VentoTran/HUST_Project_2_20211/REFERENCE/Firm_Lib/2.4inch_SPI_Module_ILI9341_MSP2402_V1.1/1-Demo/Demo_Arduino/picture/Example_03_colligate_test/Example_03-011.jpg

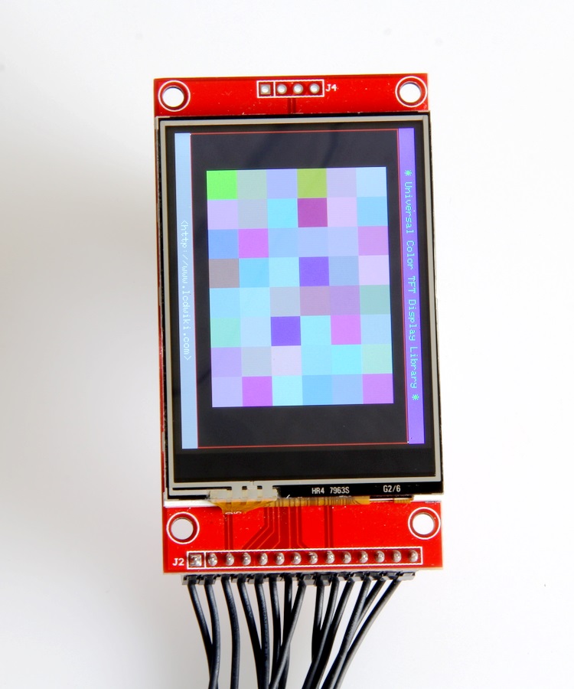
REFERENCE/Firm_Lib/2.4inch_SPI_Module_ILI9341_MSP2402_V1.1/1-Demo/Demo_Arduino/picture/Example_03_colligate_test/Example_03-011.jpg
