VentoTran/HUST_Project_2_20211/README.md

# Project2-20211
Project 2 is a project mainly focus on power electronic devices.
