VentoTran/HUST_Project_2_20211/Images/248281724_363296638787562_6036973718591148069_n.jpg

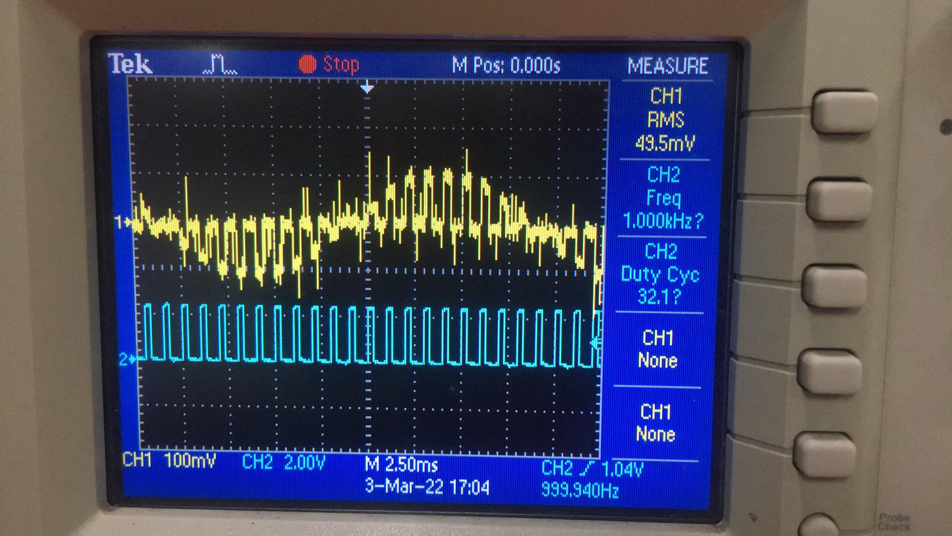
Images/248281724_363296638787562_6036973718591148069_n.jpg
