VentoTran/HUST_Project_2_20211/Images/273696500_965443047669304_2529746146208866558_n.jpg

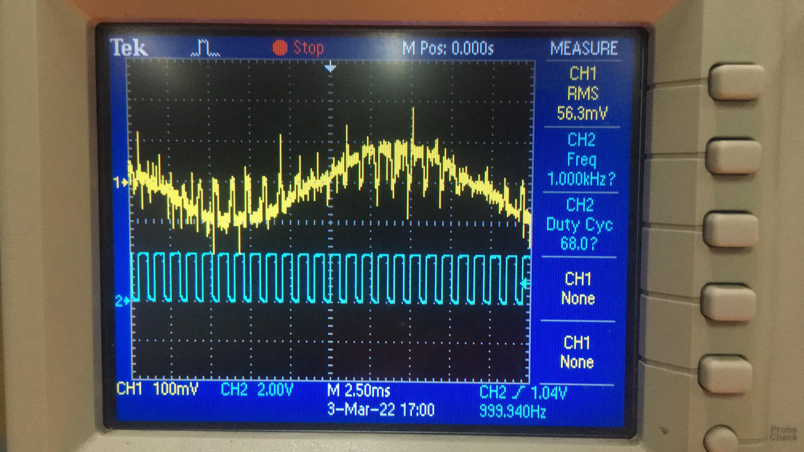
Images/273696500_965443047669304_2529746146208866558_n.jpg
