VentoTran/HUST_Project_2_20211/Images/273705237_665765731232288_4096942778341260248_n.jpg

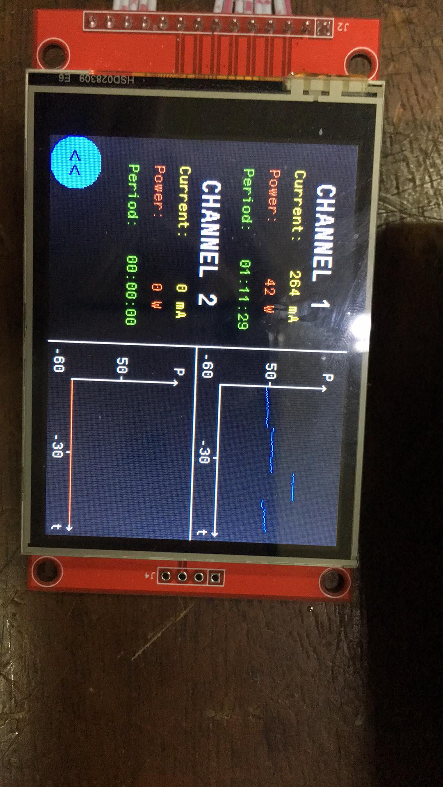
Images/273705237_665765731232288_4096942778341260248_n.jpg
