VentoTran/HUST_Project_2_20211/Images/273864193_5540946679260011_4685652792242781632_n.jpg

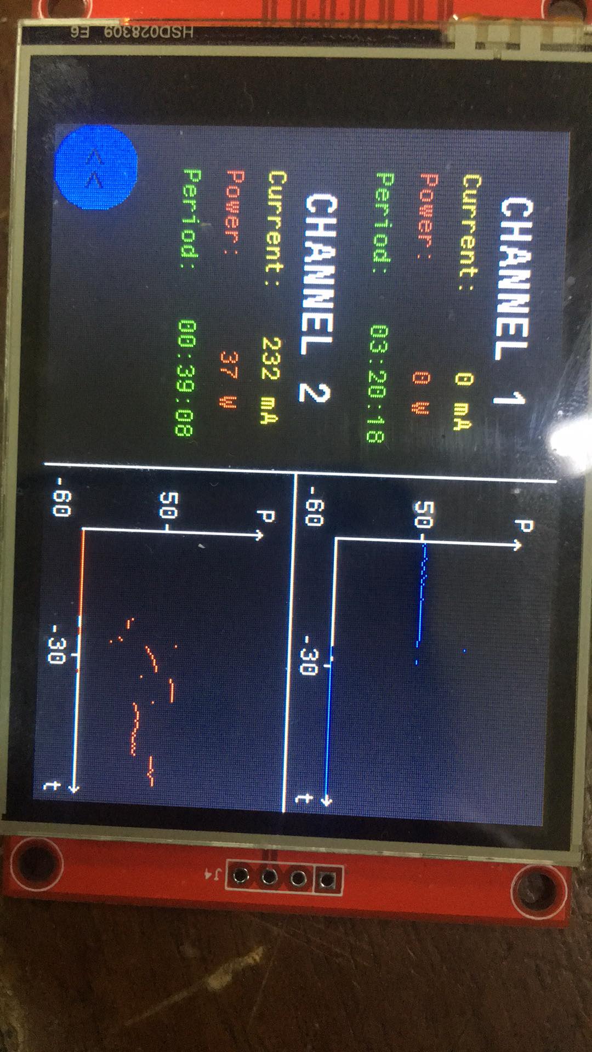
Images/273864193_5540946679260011_4685652792242781632_n.jpg
