VentoTran/HUST_Project_2_20211/Images/Project 2_20212.png

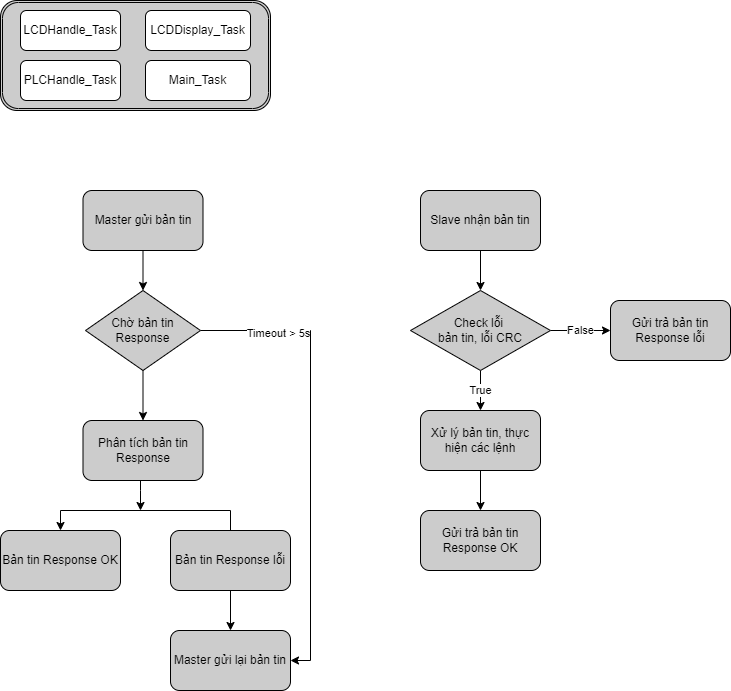
Images/Project 2_20212.png
