VentoTran/HUST_Project_2_20211/Images/Project_2_Slave.drawio.png

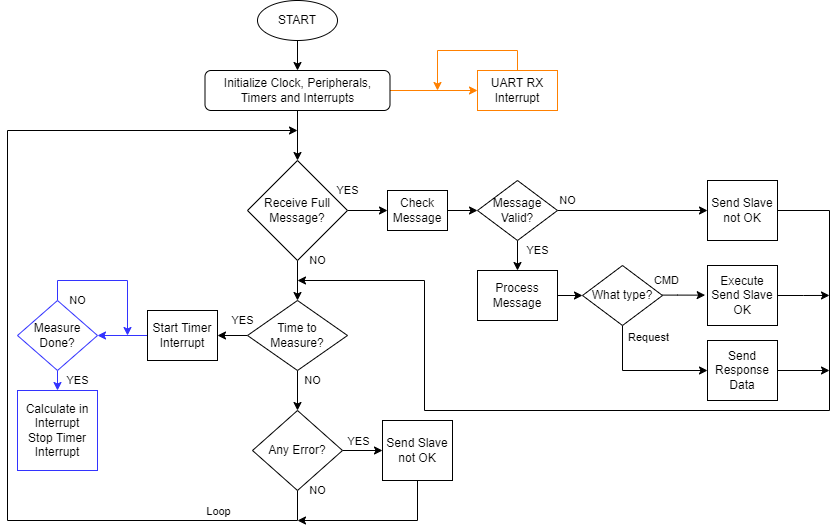
Images/Project_2_Slave.drawio.png
