VentoTran/HUST_Project_2_20211/Images/z3213941388070_df7a3ac738dd3a2199d7acfdcec778d1.jpg

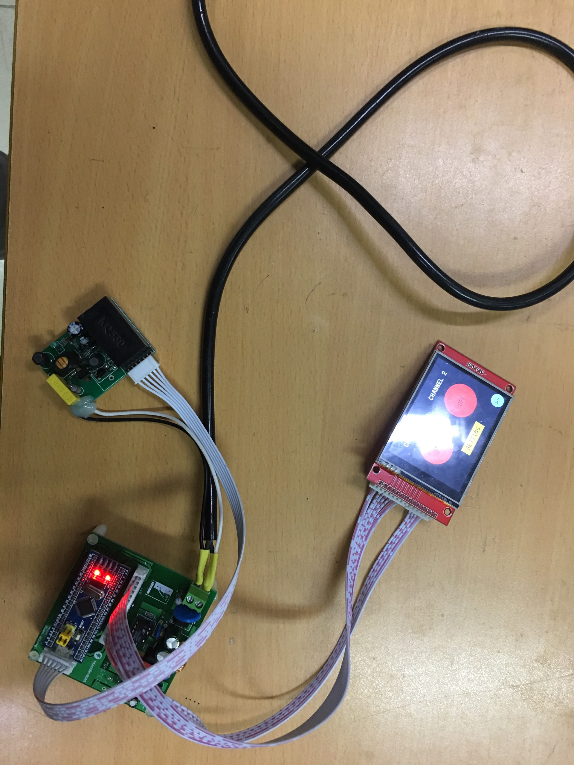
Images/z3213941388070_df7a3ac738dd3a2199d7acfdcec778d1.jpg
