VentoTran/HUST_Project_2_20211/Images/z3213941421099_bf4173346947715221769806f4465ea7.jpg

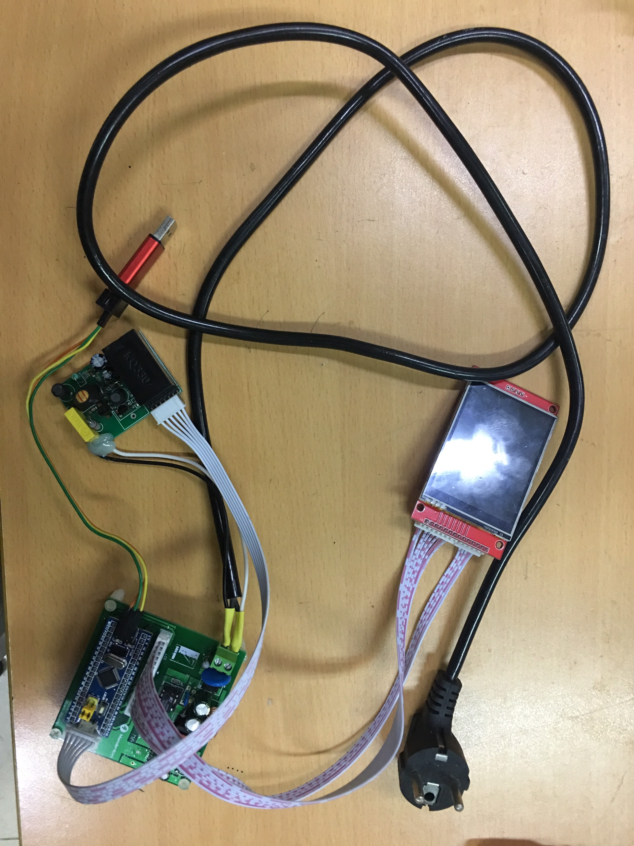
Images/z3213941421099_bf4173346947715221769806f4465ea7.jpg
