VentoTran/HUST_Project_2_20211/Images/z3213941459730_834b902f62a23d79abc02fcaa71281bd.jpg

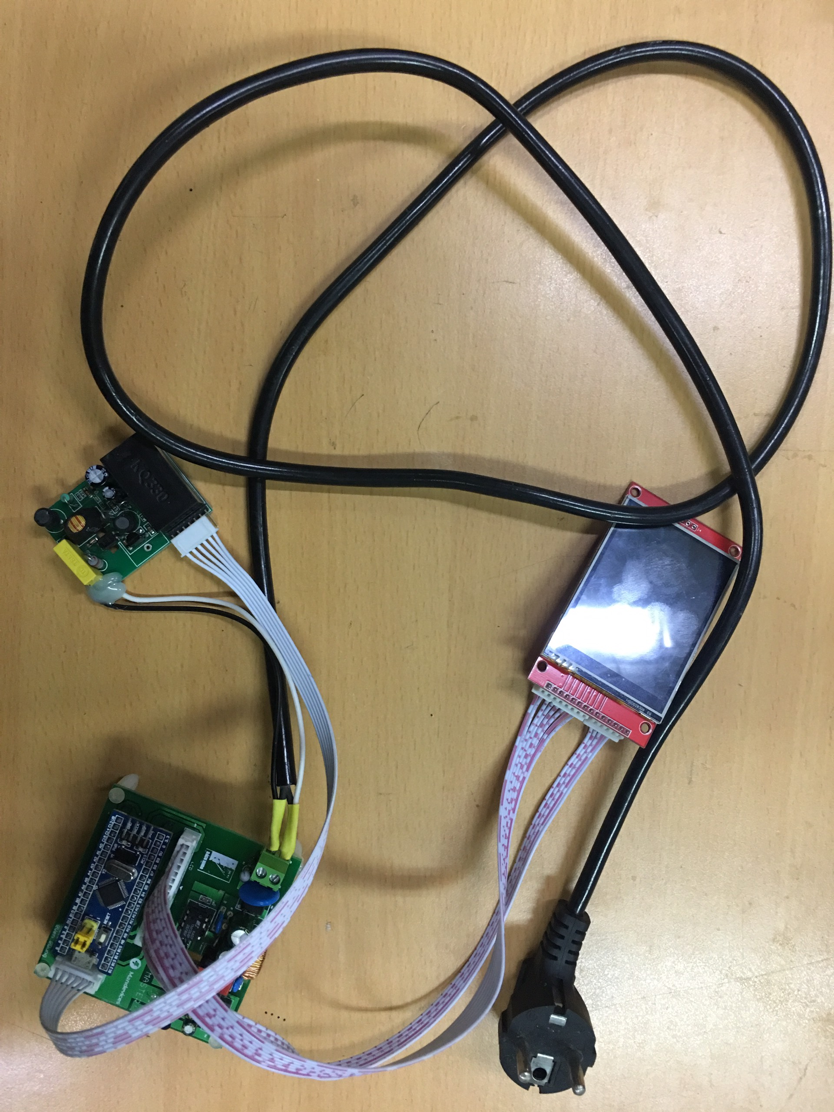
Images/z3213941459730_834b902f62a23d79abc02fcaa71281bd.jpg
