VentoTran/HUST_Project_2_20211/Images/z3213941505135_e4d84758d8ef27eb2e7979a3d5ddf65f.jpg

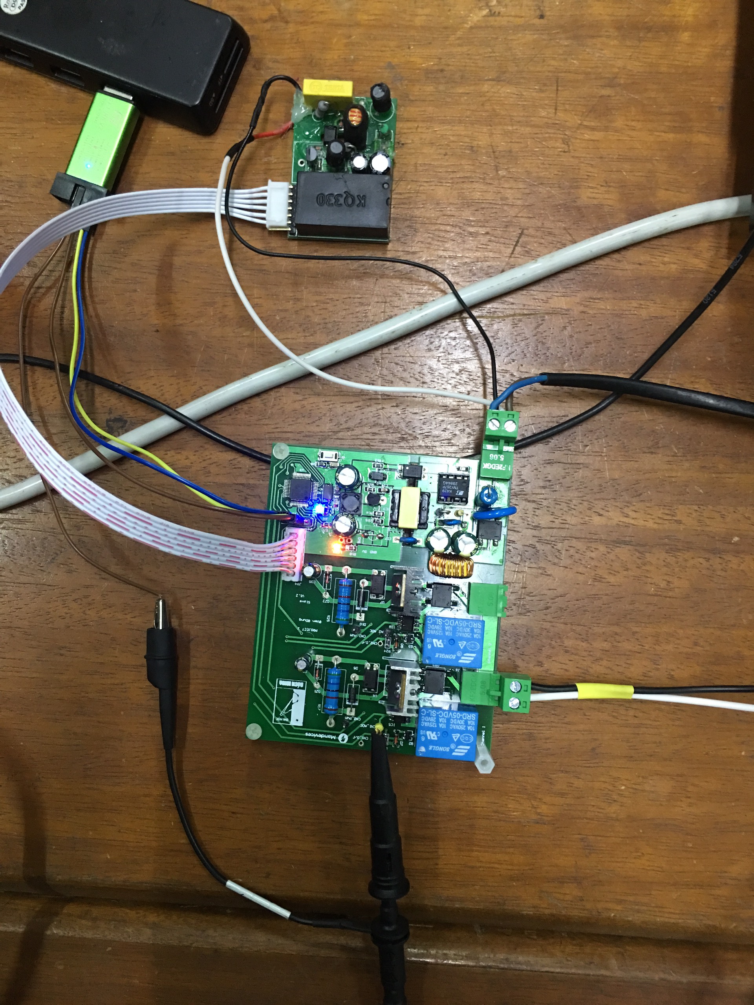
Images/z3213941505135_e4d84758d8ef27eb2e7979a3d5ddf65f.jpg
