VentoTran/HUST_Project_2_20211/Images/z3213947550361_91e1d9df06c0983117548f0ecc657220.jpg

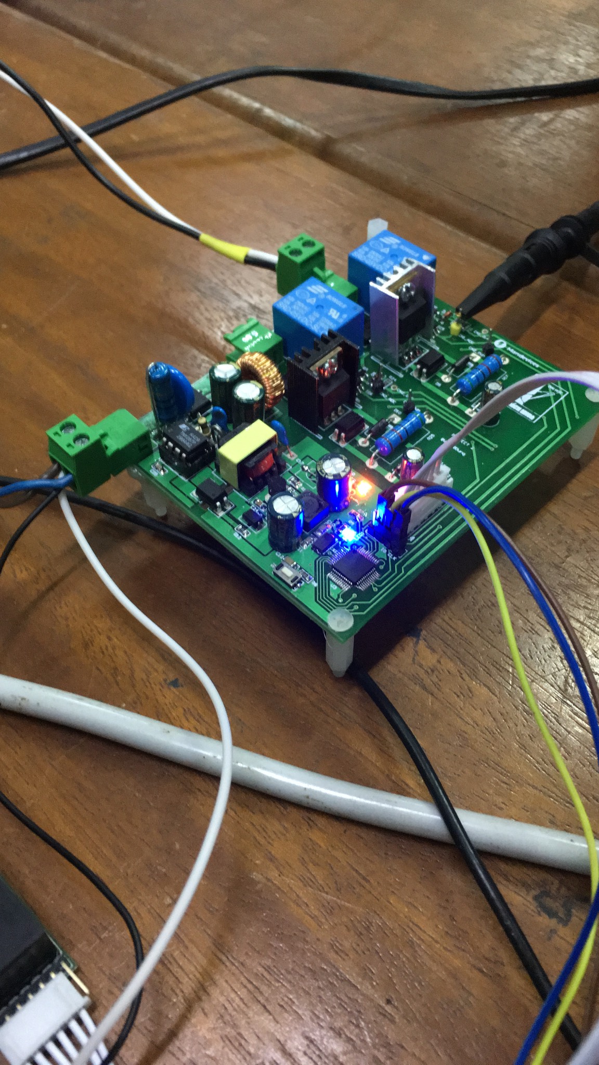
Images/z3213947550361_91e1d9df06c0983117548f0ecc657220.jpg
