VentoTran/HUST_Project_2_20211/Images/z3246583145252_d90a0f19852226688e88b4c29d732f3a.jpg

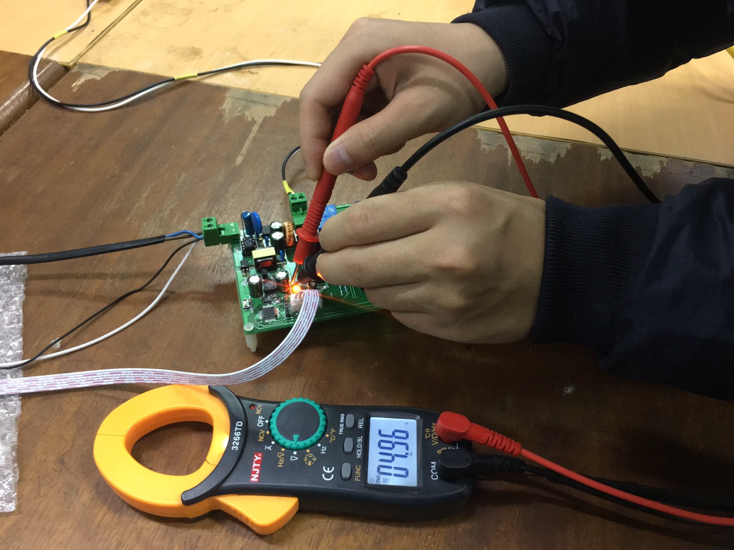
Images/z3246583145252_d90a0f19852226688e88b4c29d732f3a.jpg
