VentoTran/HUST_Project_2_20211/Images/z3246583157266_f33923b58f7bb78e84d28dd5bc3838a6.jpg

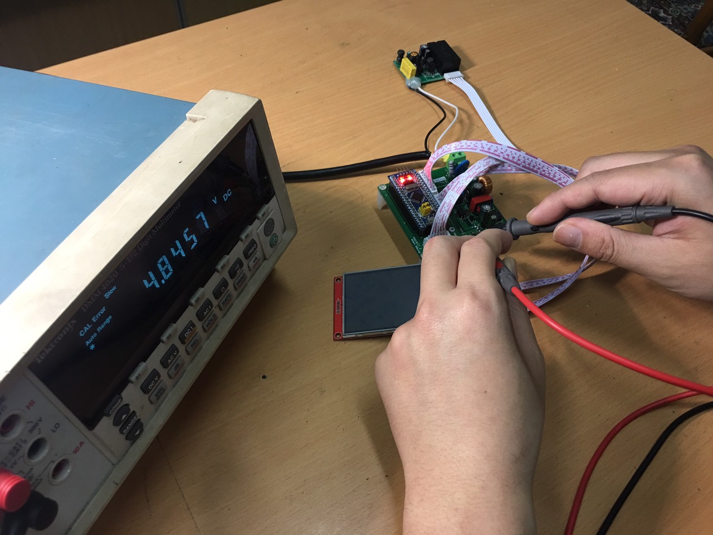
Images/z3246583157266_f33923b58f7bb78e84d28dd5bc3838a6.jpg
