VentoTran/HUST_Project_2_20211/Images/z3246583173770_56cc4fda357871a93e6800f27ae20290.jpg

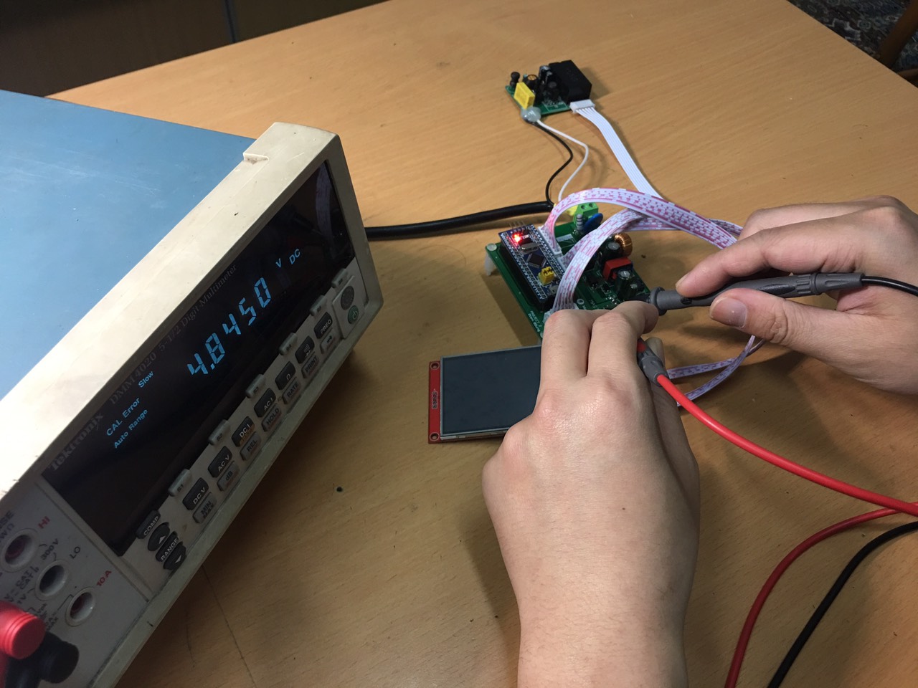
Images/z3246583173770_56cc4fda357871a93e6800f27ae20290.jpg
