VentoTran/HUST_Project_2_20211/Images/z3246583190636_7765dfef8c4e2477118ef9d839d3d7f9.jpg

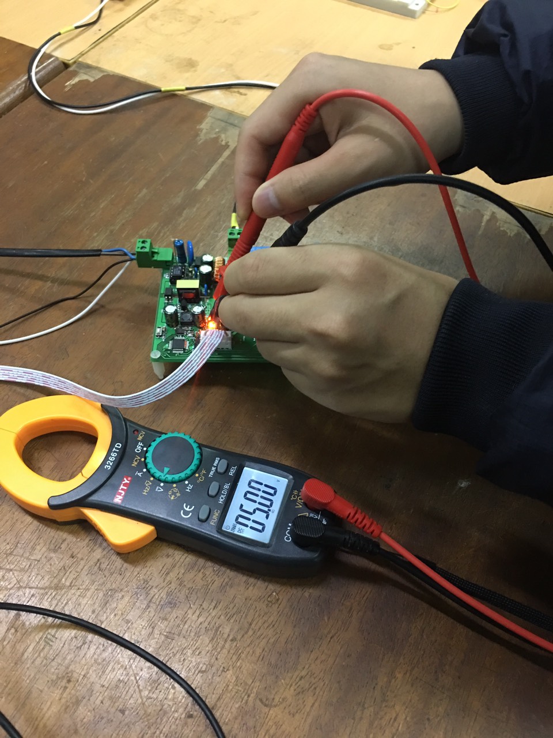
Images/z3246583190636_7765dfef8c4e2477118ef9d839d3d7f9.jpg
