VentoTran/HUST_Project_2_20211/Images/z3246583221989_2ed6a32a6cd7942403a649d9f305a56d.jpg

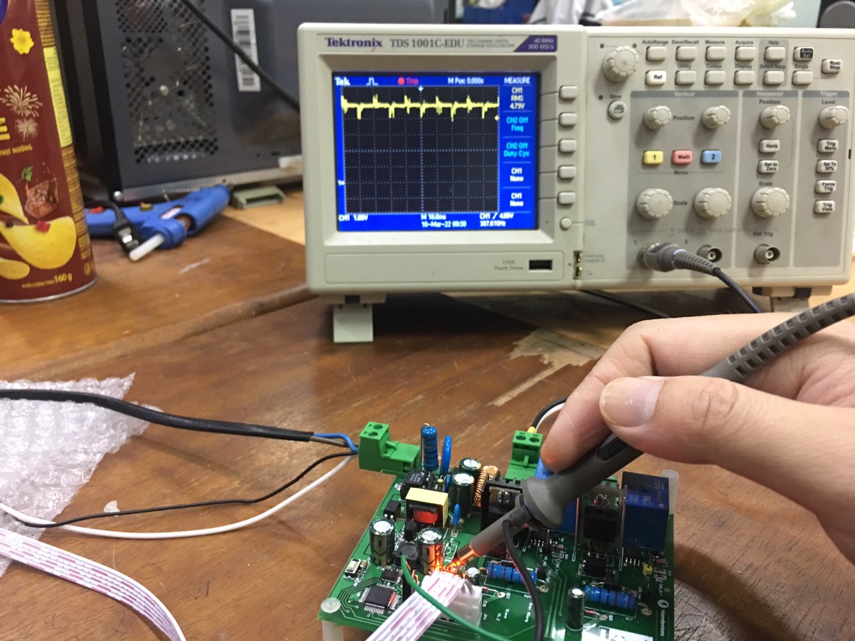
Images/z3246583221989_2ed6a32a6cd7942403a649d9f305a56d.jpg
