VentoTran/HUST_Project_2_20211/Images/z3246583233914_0fed8df94898ffd4ff99148eb5e8741e.jpg

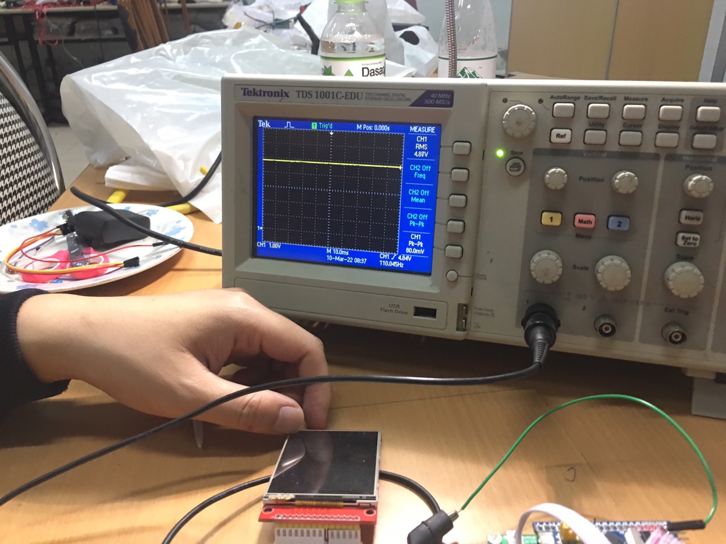
Images/z3246583233914_0fed8df94898ffd4ff99148eb5e8741e.jpg
