VentoTran/HUST_Project_2_20211/Images/z3246583259622_7a51a25334fed131e9be066b90a26500.jpg

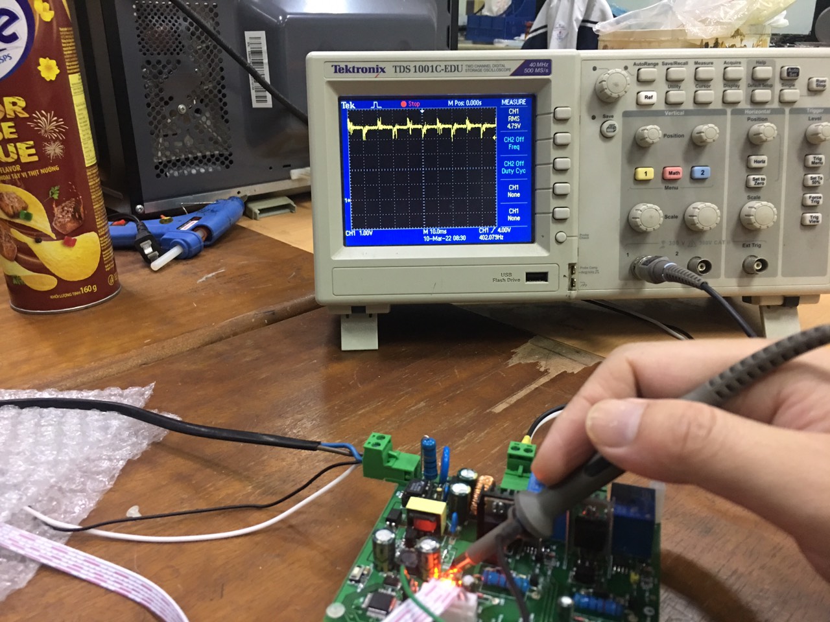
Images/z3246583259622_7a51a25334fed131e9be066b90a26500.jpg
