VentoTran/HUST_Project_2_20211/Images/z3246583263590_ccc9b801db0ff79d6d44750687cb3c98.jpg

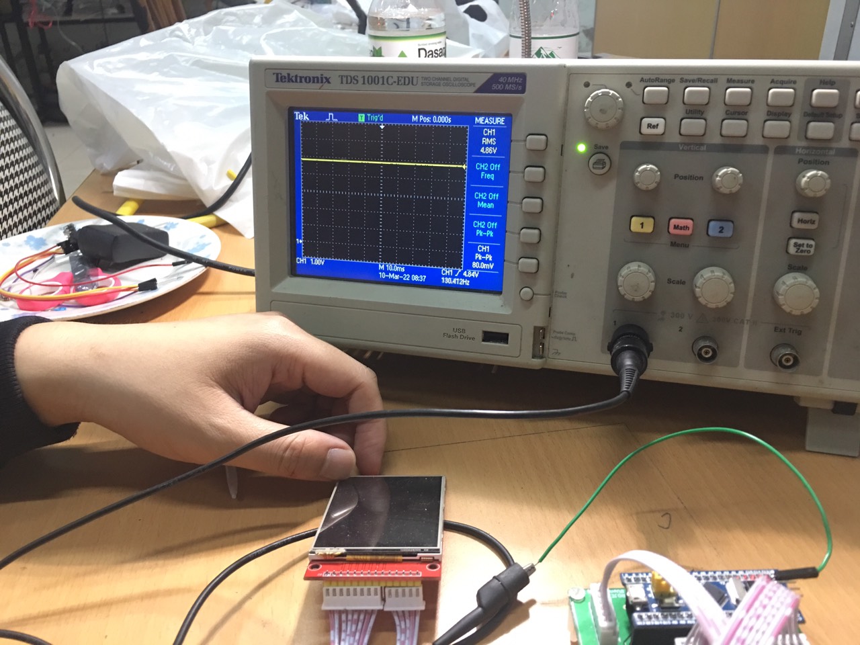
Images/z3246583263590_ccc9b801db0ff79d6d44750687cb3c98.jpg
