VentoTran/HUST_Project_2_20211/REFERENCE/Firm_Lib/2.4inch_SPI_Module_ILI9341_MSP2402_V1.1/1-Demo/Demo_Arduino/picture/Example_02_clear_screen/Example_02-002.jpg

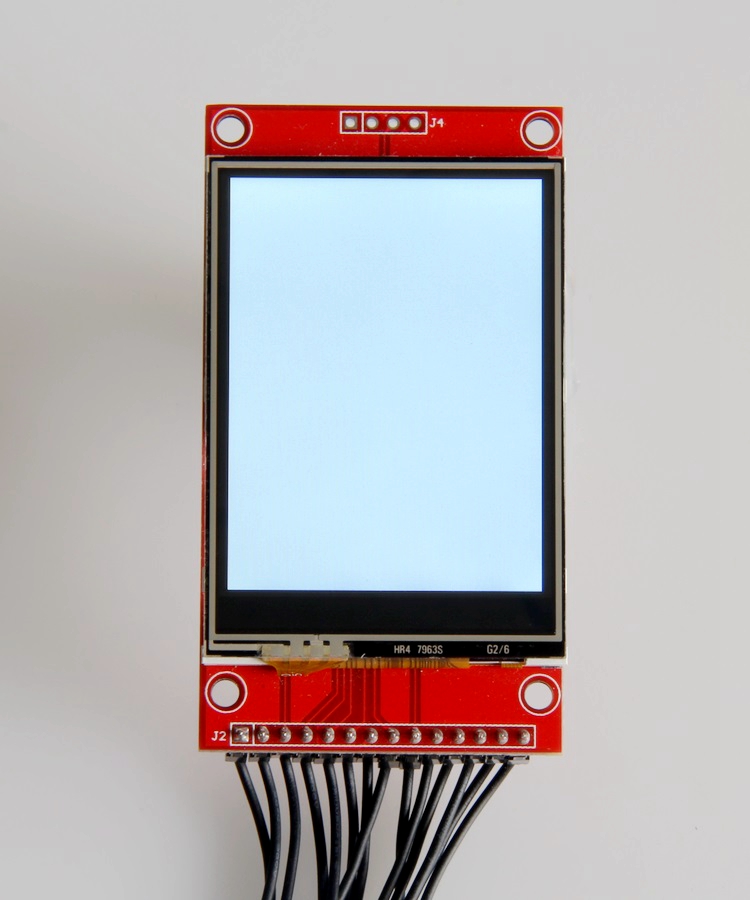
REFERENCE/Firm_Lib/2.4inch_SPI_Module_ILI9341_MSP2402_V1.1/1-Demo/Demo_Arduino/picture/Example_02_clear_screen/Example_02-002.jpg
