VentoTran/HUST_Project_2_20211/REFERENCE/Firm_Lib/2.4inch_SPI_Module_ILI9341_MSP2402_V1.1/7-Character&Picture_Molding_Tool/Tools-Image2Lcd 2.9/STM32图片显示例程取模设置参考.gif

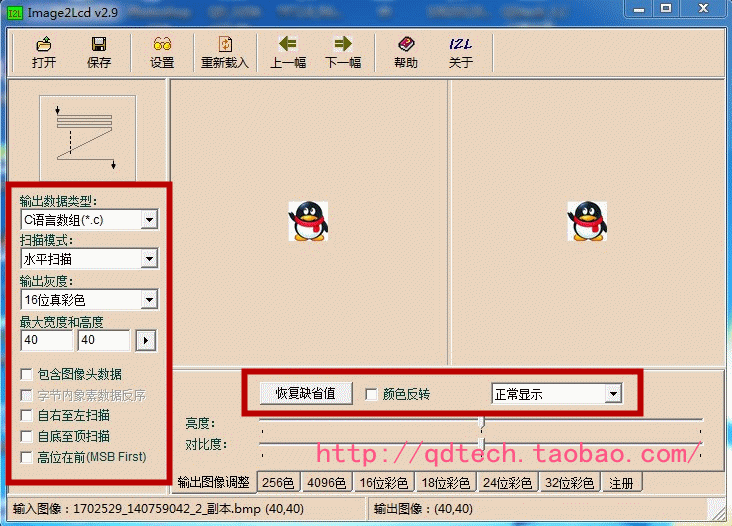
REFERENCE/Firm_Lib/2.4inch_SPI_Module_ILI9341_MSP2402_V1.1/7-Character&Picture_Molding_Tool/Tools-Image2Lcd 2.9/STM32图片显示例程取模设置参考.gif
