VentoTran/HUST_Project_2_20211/REFERENCE/Firm_Lib/2.4inch_SPI_Module_ILI9341_MSP2402_V1.1/7-Character&Picture_Molding_Tool/Tools-PCtoLCD200/16X16汉字取模设置2.gif

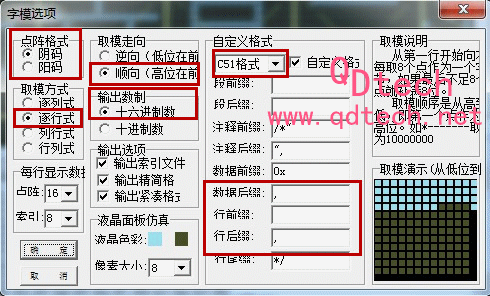
REFERENCE/Firm_Lib/2.4inch_SPI_Module_ILI9341_MSP2402_V1.1/7-Character&Picture_Molding_Tool/Tools-PCtoLCD200/16X16汉字取模设置2.gif
