VentoTran/HUST_Project_2_20211/HARDWARE/Project_2_Slave_PCB.xlsx

Designator | Comment | Description | Footprint | Quantity
C10, C13 | 1uF | Capacitor | CAP_0805 | 2
C11, C14 | 22pF | Capacitor | CAP_0805 | 2
C12, C24, C25, C26, C29 | 100nF | Capacitor | CAP_0805 | 5
C15, C16 | JP4 | WR-PHD 2.54 mm Angled Socket Header | JP4-C1T | 2
C17, C18 | 1nF/400v | CAP CERAMIC | 103/2KV | 2
C19 | 10uF/400V | Polarized Capacitor (Axial) | CAP-ALU-SMD-5x5.5x1.4 | 1
C20 | 10uF/400V | Polarized Capacitor (Axial) | C3MM | 1
C21 | 20D471K | Varistor | 103/2KV | 1
C22 | 470uF/16V | Polarized Capacitor (Axial) | C3MM | 1
C23 | 100uF/16V | Polarized Capacitor (Axial) | C3MM | 1
C27, C31 | Cap Pol | Polarized Capacitor (Axial) | C5mm | 2
C28, C30 | 10nF | Capacitor | CAP_0805 | 2
D3, D4 | SS14 | Diode Schottky 1N5819 | SMAJ | 2
D5, D10 | 1N4007 | Diode 1A | D2A | 2
D6, D7, D8, D9 | 1N4148 | Schottky Rectifiers | 1N4148_SMD | 4
DB2 | Diode Bridge | Diode Bridge | DB207S | 1
DB3, DB4 | Diode Bridge Flate | Diode Bridge | DB207S | 2
DZ1, DZ2 | Zener-12V |  | D1A | 2
IC3 | STM8S003F3P6 | MCU 8BIT 8KB FLASH TSSOP-20 | TSSOP-20 | 1
IC4 | TL431 | Programmable Shunt Regulator | qto-92 | 1
IC5 | TNY264 | Enhanced, Energy Efficient, Low Power Off-line Switcher | DIP8 | 1
IC6, IC7 | Current Sensor IC |  | SOIC-8 | 2
J4 | AC-IN |  | KF2-5.08 | 1
J5 | LOAD1 |  | KF2-5.08T | 1
J6 | LOAD2 |  | KF2-5.08T | 1
JP4 | Con6 | PLC module | CON6 | 1
L3 | 100uF | Inductor | L-DIP-M-9.5x6 | 1
L4 | 2.2uF | Inductor | L-SMD-M-7.3x4.5 | 1
LED1 | LED | LED Single colour Green and Red | LED-0805-Blue | 1
LED2 | LED | LED Single colour Green and Red | LED-0805-Red | 1
Q1, Q4 | IRF840 | MOSFET N - CHANNEL 500V - 0.75 - 8A - TO-220 | QTO-220H3 | 2
Q2, Q3 | 2SC1815 | NPN 600mW, ECB | SOT23 | 2
R7, R8, R18, R23 | 1k | Resistor | RES-SMD-0805 | 4
R9, R14, R15, R17, R22 | 10k | Resistor, Resistor - DIP | RES-SMD-0805 | 5
R10 | 100k | Resistor | RES-SMD-0805 | 1
R11 | 200R | Resistor | RES-SMD-0805 | 1
R12 | 10R | Resistor | RES-SMD-0805 | 1
R13 | 3.3k | Resistor | RES-SMD-0805 | 1
R16, R21 | 56k/2W | Resistor - DIP | RES-2W | 2
R19, R20 | 100R | Resistor | RES-SMD-0805 | 2
RL1, RL2 | Relay 10A/12V | Relay SPDT,10A - 12VDC 5 Pin | RL_SPDT_10A | 2
S1 | SW-SMD | Switch | SW 3x2x4 | 1
SW2 | SW | Switch button 2 pin | SW2 | 1
Transf2 | Transformer EE16 |  | Transformer SW | 1
U3 | PC817 | Single Opto | DIP4/W0.3 | 1
U4, U5 | OPTO | Single Opto | OPTO | 2
X1 | 8Mhz | Crystal For all Crystal 2pin. | XT2 | 1
