VentoTran/HUST_Project_2_20211/(list of files, drawings)

Other design files:
HARDWARE/[01] - Block Diagram.SchDoc
HARDWARE/[02] - Sheet Connector.SchDoc
HARDWARE/[03] - Master_MCU.SchDoc
HARDWARE/[04] - Master_Power.SchDoc
HARDWARE/[05] - Master_Display.SchDoc
HARDWARE/[06] - Master_PLCModule.SchDoc
HARDWARE/[07] - Slave_MCU.SchDoc
HARDWARE/[08] - Slave_Power.SchDoc
HARDWARE/[09] - Slave_Sensor & Output.SchDoc
HARDWARE/[10] - Slave_PLCModule.SchDoc
HARDWARE/Project_2.PrjPCB
HARDWARE/Project_2_Master_PCB.PcbDoc
HARDWARE/Project_2_Slave_PCB.PcbDoc
HARDWARE/Project_2_Slave_PCB_V1_1.PcbDoc
REFERENCE/TNy264 Flyback/Flyback.PrjPCB
REFERENCE/TNy264 Flyback/PCB.PcbDoc
REFERENCE/TNy264 Flyback/schematic.SchDoc
