VentoTran/HUST_Project_2_20211/FIRMWARE/Slave/STM32/STM32F1_Slave/STM32F1_Slave.ioc

Mcu.UserName=STM32F103C8Tx
PA0-WKUP.GPIO_Label=ADC_CN1
PA0-WKUP.Signal=ADCx_IN0
PA1.GPIO_Label=ADC_CN2
PA1.Signal=ADCx_IN1
PA10.Signal=USART1_RX
PA13.Signal=SYS_JTMS-SWDIO
PA14.Signal=SYS_JTCK-SWCLK
PA2.GPIO_Label=PWM_CN1
PA2.Signal=S_TIM2_CH3
PA3.GPIO_Label=PWM_CN2
PA3.Signal=S_TIM2_CH4
PA9.Signal=USART1_TX
PB6.GPIO_Label=OF_CN1
PB6.Signal=GPIO_Output
PB7.GPIO_Label=OF_CN2
PB7.Signal=GPIO_Output
PC13-TAMPER-RTC.GPIO_Label=LED
PC13-TAMPER-RTC.Signal=GPIO_Output
PD0-OSC_IN.Signal=RCC_OSC_IN
PD1-OSC_OUT.Signal=RCC_OSC_OUT
