VentoTran/HUST_Project_2_20211/FIRMWARE/Master/Project_2_Master/Core/Inc/main.h

#define LED_Pin GPIO_PIN_13
#define LED_GPIO_Port GPIOC
#define LCD_SS_Pin GPIO_PIN_12
#define LCD_SS_GPIO_Port GPIOB
#define SCK_Pin GPIO_PIN_13
#define SCK_GPIO_Port GPIOB
#define MISO_Pin GPIO_PIN_14
#define MISO_GPIO_Port GPIOB
#define MOSI_Pin GPIO_PIN_15
#define MOSI_GPIO_Port GPIOB
#define TOUCH_SS_Pin GPIO_PIN_8
#define TOUCH_SS_GPIO_Port GPIOA
#define LCD_RS_Pin GPIO_PIN_11
#define LCD_RS_GPIO_Port GPIOA
#define LCD_DC_Pin GPIO_PIN_12
#define LCD_DC_GPIO_Port GPIOA
#define LCD_LED_Pin GPIO_PIN_15
#define LCD_LED_GPIO_Port GPIOA
#define TOUCH_IRQ_Pin GPIO_PIN_3
#define TOUCH_IRQ_GPIO_Port GPIOB
#define TOUCH_IRQ_EXTI_IRQn EXTI3_IRQn
