VentoTran/HUST_Project_2_20211/FIRMWARE/Master/Project_2_Master/Core/Inc/lcd.h

/* vim: set ai et ts=4 sw=4: */
#ifndef __ILI9341_H__
#define __ILI9341_H__

#include "font.h"
#include "touch.h"
#include <stdbool.h>

#define ILI9341_MADCTL_MY  0x80
#define ILI9341_MADCTL_MX  0x40
#define ILI9341_MADCTL_MV  0x20
#define ILI9341_MADCTL_ML  0x10
#define ILI9341_MADCTL_RGB 0x00
#define ILI9341_MADCTL_BGR 0x08
#define ILI9341_MADCTL_MH  0x04

/*** Redefine if necessary ***/
#define ILI9341_SPI_PORT hspi2
extern SPI_HandleTypeDef ILI9341_SPI_PORT;

#define ILI9341_RES_Pin       GPIO_PIN_11
#define ILI9341_RES_GPIO_Port GPIOA
#define ILI9341_CS_Pin        GPIO_PIN_12
#define ILI9341_CS_GPIO_Port  GPIOB
#define ILI9341_DC_Pin        GPIO_PIN_12
#define ILI9341_DC_GPIO_Port  GPIOA
#define ILI9341_LED_Pin       GPIO_PIN_15
#define ILI9341_LED_GPIO_Port GPIOA


#define ROTATION    1

#if ROTATION == 0
#define ILI9341_WIDTH  240
#define ILI9341_HEIGHT 320
#define ILI9341_ROTATION (ILI9341_MADCTL_MX | ILI9341_MADCTL_BGR)

#elif ROTATION == 1
#define ILI9341_WIDTH  320
#define ILI9341_HEIGHT 240
#define ILI9341_ROTATION (ILI9341_MADCTL_MX | ILI9341_MADCTL_MY | ILI9341_MADCTL_MV | ILI9341_MADCTL_BGR)

#elif ROTATION == 2
#define ILI9341_WIDTH  320
#define ILI9341_HEIGHT 240
#define ILI9341_ROTATION (ILI9341_MADCTL_MV | ILI9341_MADCTL_BGR)

#elif ROTATION == 3
#define ILI9341_WIDTH  240
#define ILI9341_HEIGHT 320
#define ILI9341_ROTATION (ILI9341_MADCTL_MY | ILI9341_MADCTL_BGR)

#endif

/****************************/

#define MAIN_PAGE       0
#define CONTROL_PAGE    1
#define DATA_PAGE       2

/****************************/

// Color definitions
#define	ILI9341_BLACK       0x0000
#define	ILI9341_BLUE        0x001F
#define	ILI9341_RED         0xF800
#define	ILI9341_GREEN       0x07E0
#define ILI9341_CYAN        0x07FF
#define ILI9341_MAGENTA     0xF81F
#define ILI9341_YELLOW      0xFFE0
#define ILI9341_WHITE       0xFFFF
#define ILI9341_BROWN 	    0XBC40
#define ILI9341_NAVY        0x000F
#define ILI9341_PURPLE      0x780F
#define ILI9341_ORANGE      0xFD20
#define ILI9341_PINK        0xF81F
#define ILI9341_GRAY  		0X8430

#define ILI9341_BRRED 		0XFC07
#define ILI9341_DARKBLUE    0X01CF
#define ILI9341_LIGHTBLUE   0X7D7C 
#define ILI9341_GRAYBLUE    0X5458
#define ILI9341_LIGHTGREEN  0X841F
#define ILI9341_LIGHTGRAY   0XEF5B
#define ILI9341_LGRAY 	    0XC618
#define ILI9341_LGRAYBLUE   0XA651
#define ILI9341_LBBLUE      0X2B12

#define ILI9341_COLOR565(r, g, b) (((r & 0xF8) << 8) | ((g & 0xFC) << 3) | ((b & 0xF8) >> 3))




// call before initializing any SPI devices
void ILI9341_Unselect();

void ILI9341_Init(void);

void ILI9341_DrawPixel(uint16_t x, uint16_t y, uint16_t color);
void ILI9341_DrawLine(uint16_t x1, uint16_t y1, uint16_t x2, uint16_t y2, uint16_t color);
void ILI9341_WriteString(uint16_t x, uint16_t y, const char* str, FontDef font, uint16_t color, uint16_t bgcolor);
void ILI9341_DrawImage(uint16_t x, uint16_t y, uint16_t w, uint16_t h, const uint16_t* data);

void ILI9341_FillScreen(uint16_t color);
void ILI9341_InvertColors(bool invert);

void ILI9341_DrawRectangle(uint16_t x, uint16_t y, uint16_t w, uint16_t h, uint16_t color);
void ILI9341_FillRectangle(uint16_t x, uint16_t y, uint16_t w, uint16_t h, uint16_t color);

void ILI9341_DrawTriangle(uint16_t x1, uint16_t y1, uint16_t x2, uint16_t y2, uint16_t x3, uint16_t y3, uint16_t color);
void ILI9341_FillTriangle(uint16_t x1, uint16_t y1, uint16_t x2, uint16_t y2, uint16_t x3, uint16_t y3, uint16_t color);

void ILI9341_DrawCircle(uint16_t x, uint16_t y, uint16_t r, uint16_t color);
void ILI9341_FillCircle(uint16_t x, uint16_t y, uint16_t r, uint16_t color);

#endif // __ILI9341_H__
