VentoTran/HUST_Project_2_20211/(commit log)

2021-11-14 Hardware folder added
    [Project_2.PrjPCB, Project_2_PCB.PcbDoc, [01] - Block Diagram.SchDoc]
2021-11-18 Add document and complete power schematic
    [Project_2.PrjPCB, Project_2_Master_PCB.PcbDoc, Project_2_PCB.PcbDoc, Project_2_Slave_PCB.PcbDoc, [01] - Block Diagram.SchDoc, [02] - Sheet Connector.SchDoc, [03] - Master_MCU.SchDoc, [04] - Master_Power.SchDoc]
2021-12-13 Schematic 90% done
    [PinOut_Master.xlsx, PinOut_Slave.xlsx, [01] - Block Diagram.SchDoc, [02] - Sheet Connector.SchDoc, [03] - Master_MCU.SchDoc, [04] - Master_Power.SchDoc, [05] - Master_Display.SchDoc, [06] - Master_PLCModule.SchDoc]
2021-12-19 commit b4 merge
    [[09] - Slave_Sensor & Output.SchDoc]
2021-12-21 Master PCB done
    [Project_2.PrjPCB, Project_2_Slave_PCB.PcbDoc, [01] - Block Diagram.SchDoc, [02] - Sheet Connector.SchDoc, [03] - Master_MCU.SchDoc, [04] - Master_Power.SchDoc, [05] - Master_Display.SchDoc, [06] - Master_PLCModule.SchDoc]
2021-12-21 Slave PCB done
    [Project_2_Slave_PCB.PcbDoc, [07] - Slave_MCU.SchDoc, [08] - Slave_Power.SchDoc, [09] - Slave_Sensor & Output.SchDoc]
2021-12-27 fix PCB
    [Project_2.PrjPCB, Project_2_Slave_PCB.PcbDoc, [03] - Master_MCU.SchDoc]
2022-02-03 Master display complete
    [Project_2.PrjPCB, Project_2_Slave_PCB_V1_1.PcbDoc, [04] - Master_Power.SchDoc, [05] - Master_Display.SchDoc, [08] - Slave_Power.SchDoc, [09] - Slave_Sensor & Output.SchDoc]
2022-02-03 fix display bug no.01
    [Project_2_Master.ioc]
2022-02-10 Dung push UART
2022-02-10 Dung push Slave STM32F1
2022-03-01 report add
    [[04] - Master_Power.SchDoc, [08] - Slave_Power.SchDoc]
2022-03-10 push BC
    [[04] - Master_Power.SchDoc, [08] - Slave_Power.SchDoc, [09] - Slave_Sensor & Output.SchDoc]
